AronTech1/chord_hardware/Chord Board Controller.step

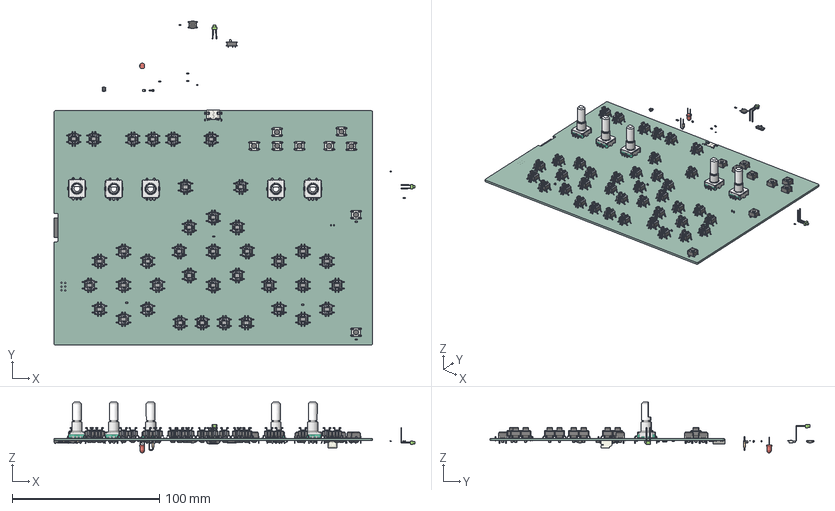
[picture p1: CAD file, 2025-10-28]
Chord Board Controller.step
244.8 x 219.7 x 34.5 mm
root x 39
(Unsaved) x 5
SW_PUSH_6mm x 9
LED_0603_1608Metric x 6
LED_D1.8mm_W1.8mm_H2.4mm_Horizontal_O6.35mm_Z8.2mm x 2
C_0402_1005Metric x 21
D_SOD_123 x 53
R_0402_1005Metric x 20
R_Axial_DIN0204_L36mm_D16mm_P254mm_Vertical
Fuse_0805_2012Metric
C_0805_2012Metric x 2
SW_SPST_TL3342 x 2
SOT_23_6
CON_TYPE-C-31-M-14 v3
R_0603_1608Metric x 11
JST_S2B_PH_K
C_0603_1608Metric x 3
holyiot_18010_nRF52840 v3
SOT_23 x 2
RGT16B
ASSEMBLY x 2
MSK12C02 v4
LED_D3.0mm
Chord Board Controller_PCB
