AronTech1/chord_hardware/step file/IS31FL3733-QFLS4-TR.stp

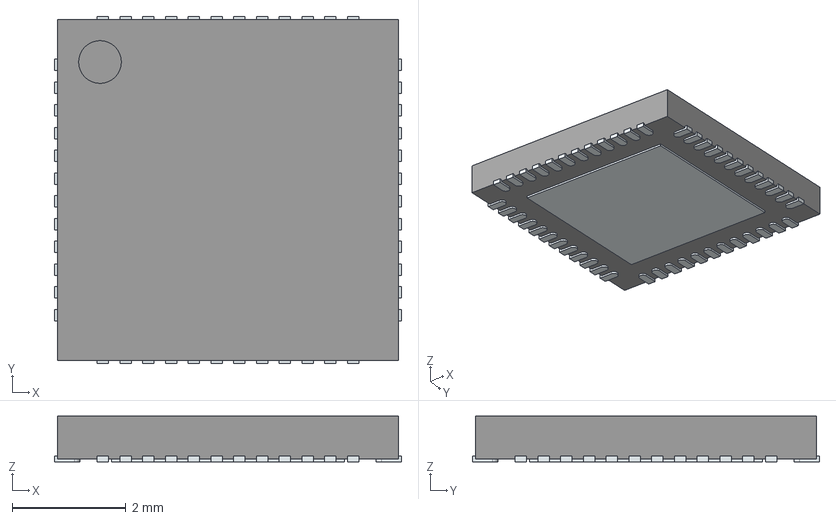
[picture p2: CAD file, 2025-10-28]
step file/IS31FL3733-QFLS4-TR.stp
6.10 x 6.10 x 0.8 mm
ThermalPin
PinsArrayLR
PinsArrayTB
