AronTech1/chord_hardware/step file/BQ24075.STEP

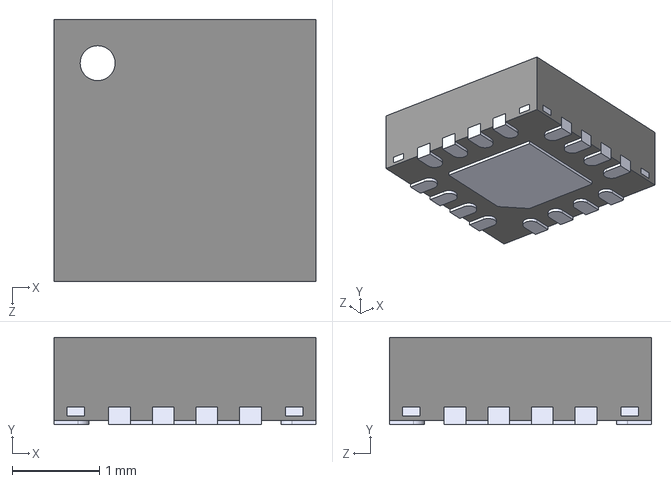
[picture p3: CAD file, 2025-10-28]
step file/BQ24075.STEP
3.00 x 1.00 x 3.00 mm
