AronTech1/chord_hardware/Schematic_19-10-25.pdf

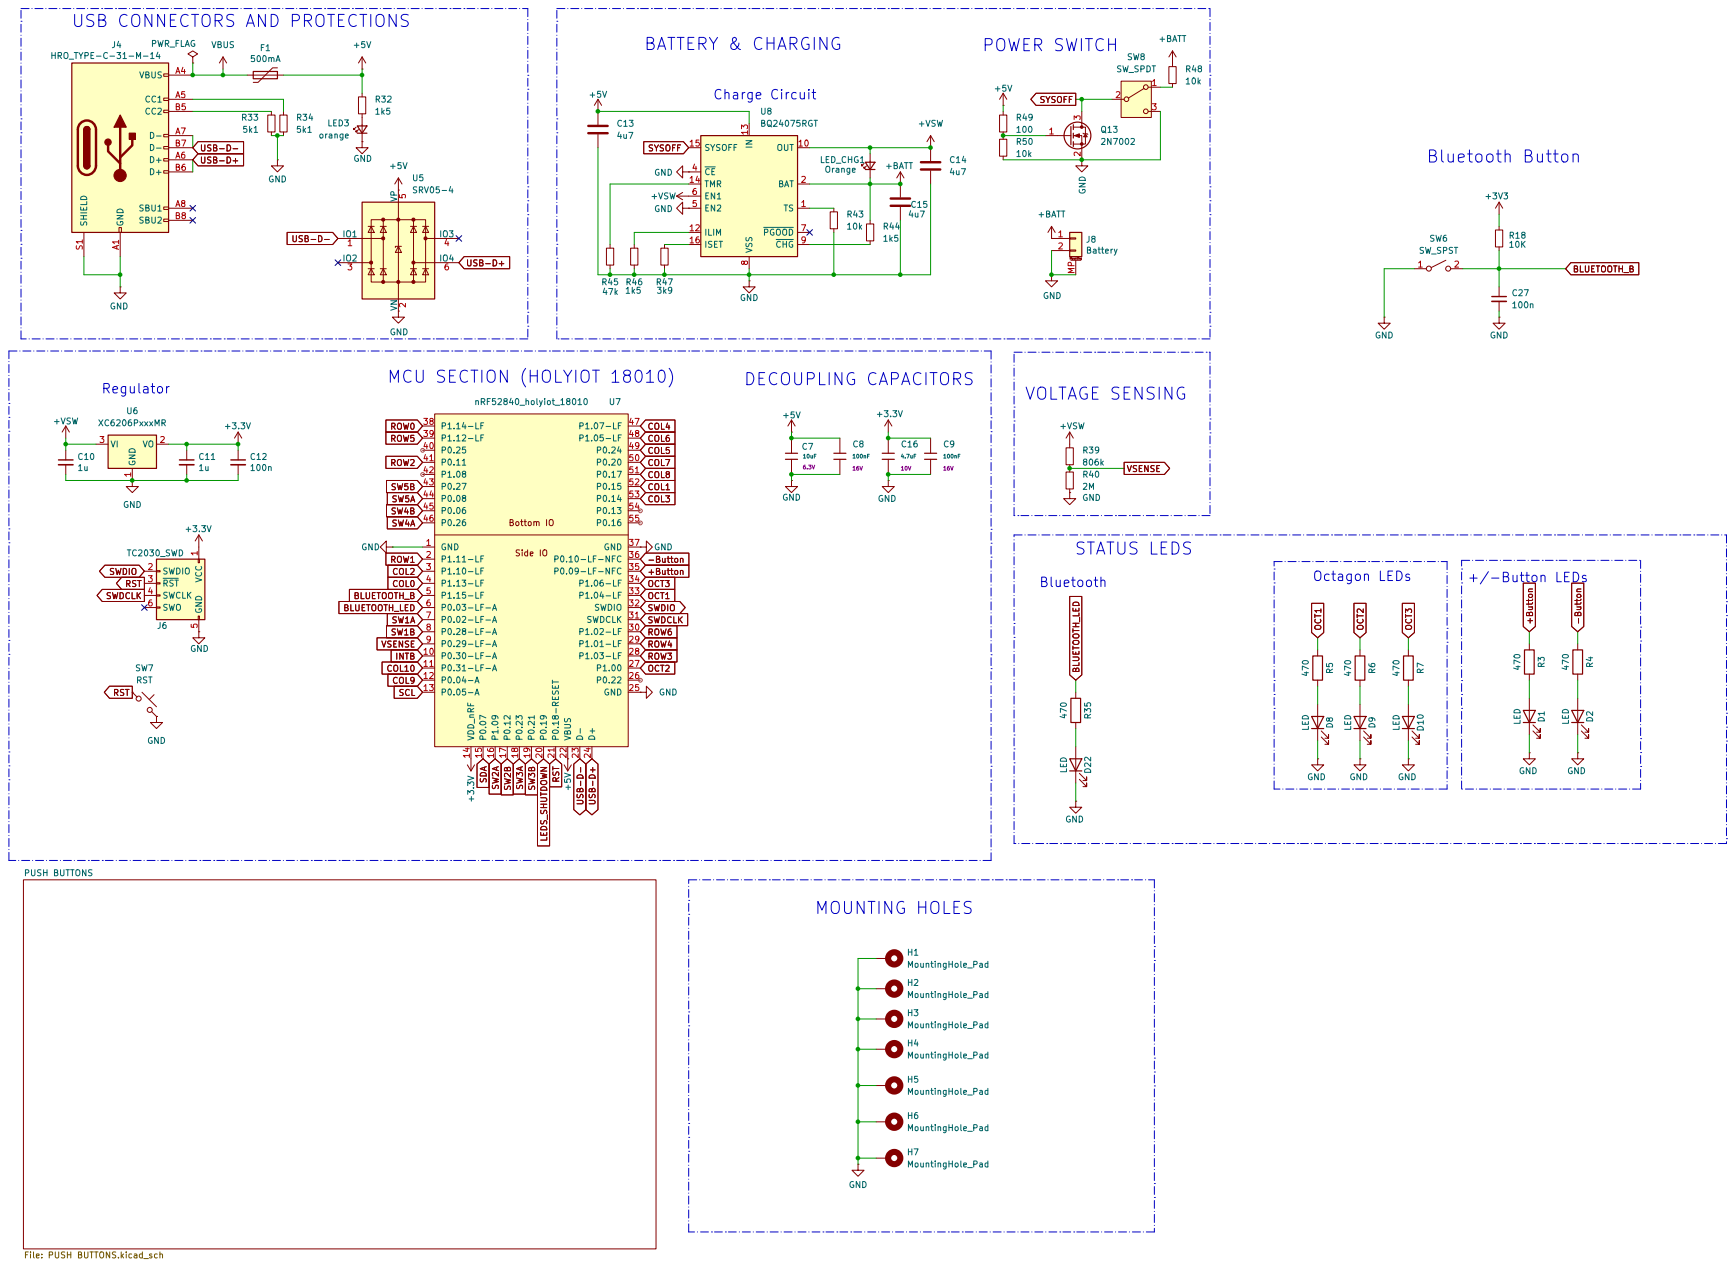
[picture p4: page 1]

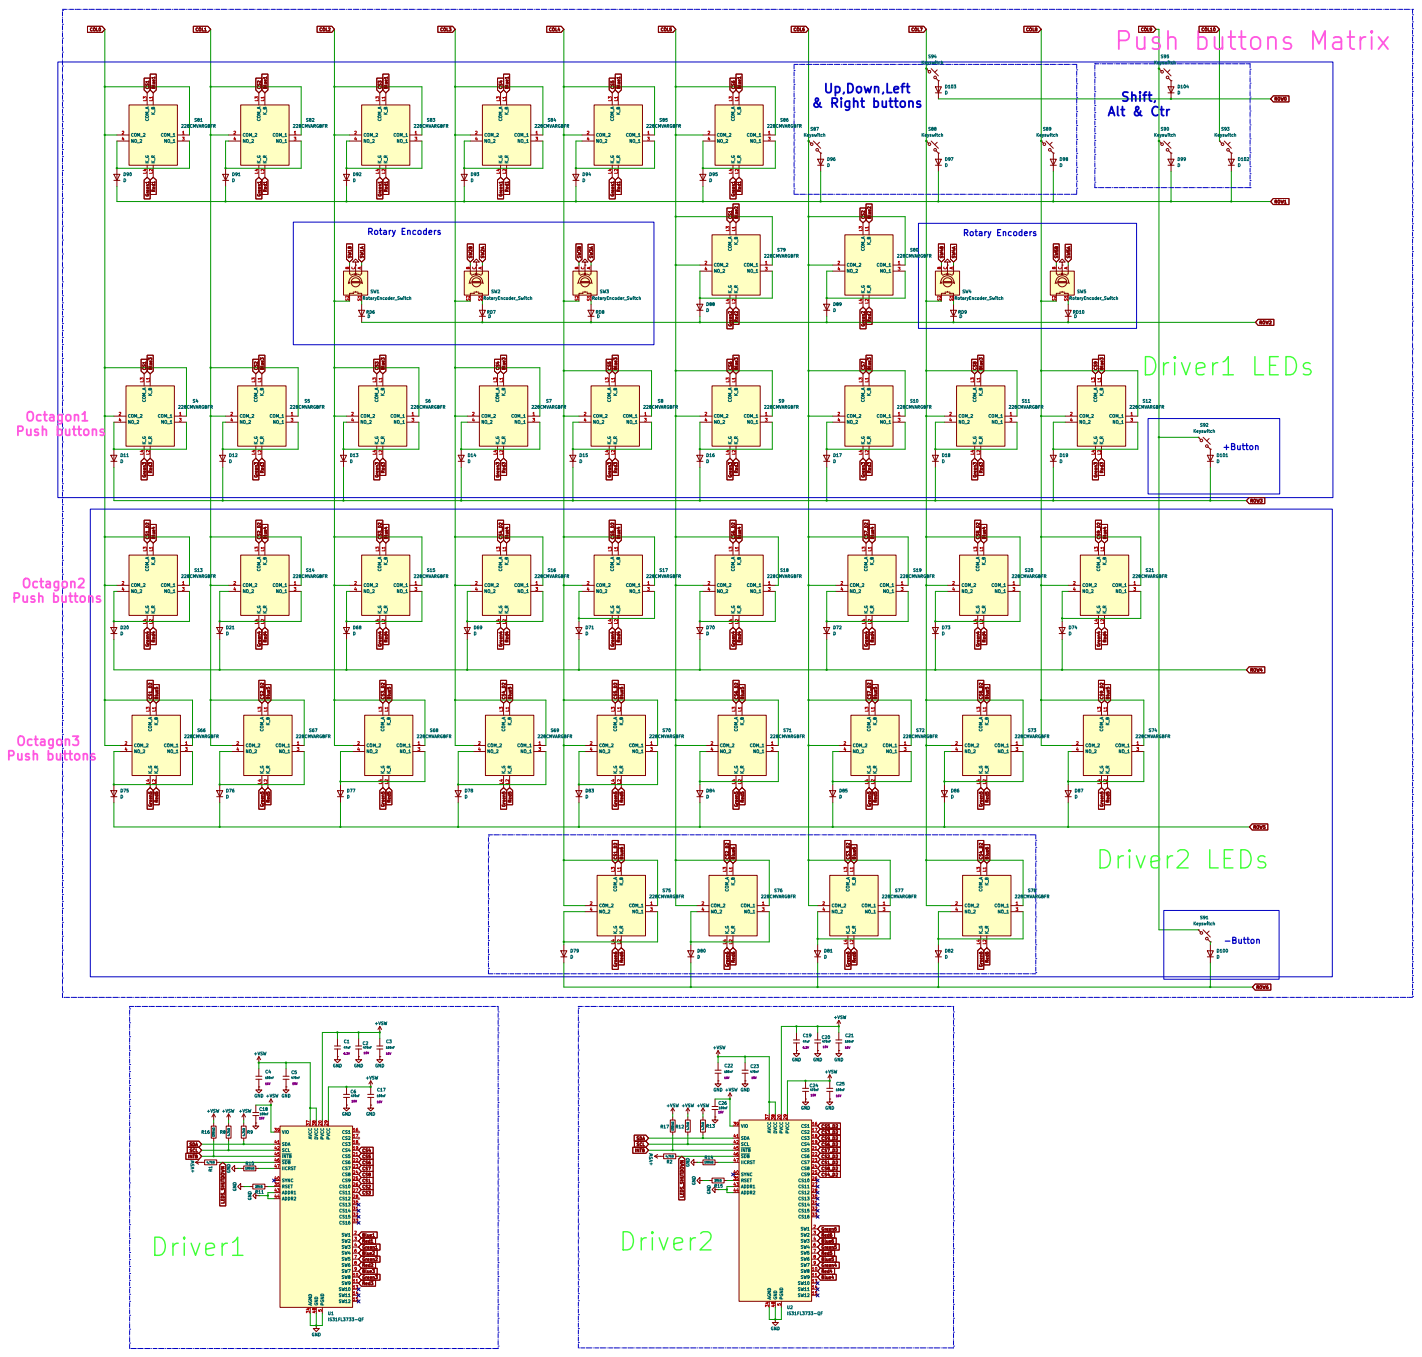
[picture p5: page 2]
