AronTech1/chord_hardware/Chord Board Controller.kicad_pcb

## KiCad design Chord Board Controller.kicad_pcb (2025-10-28)

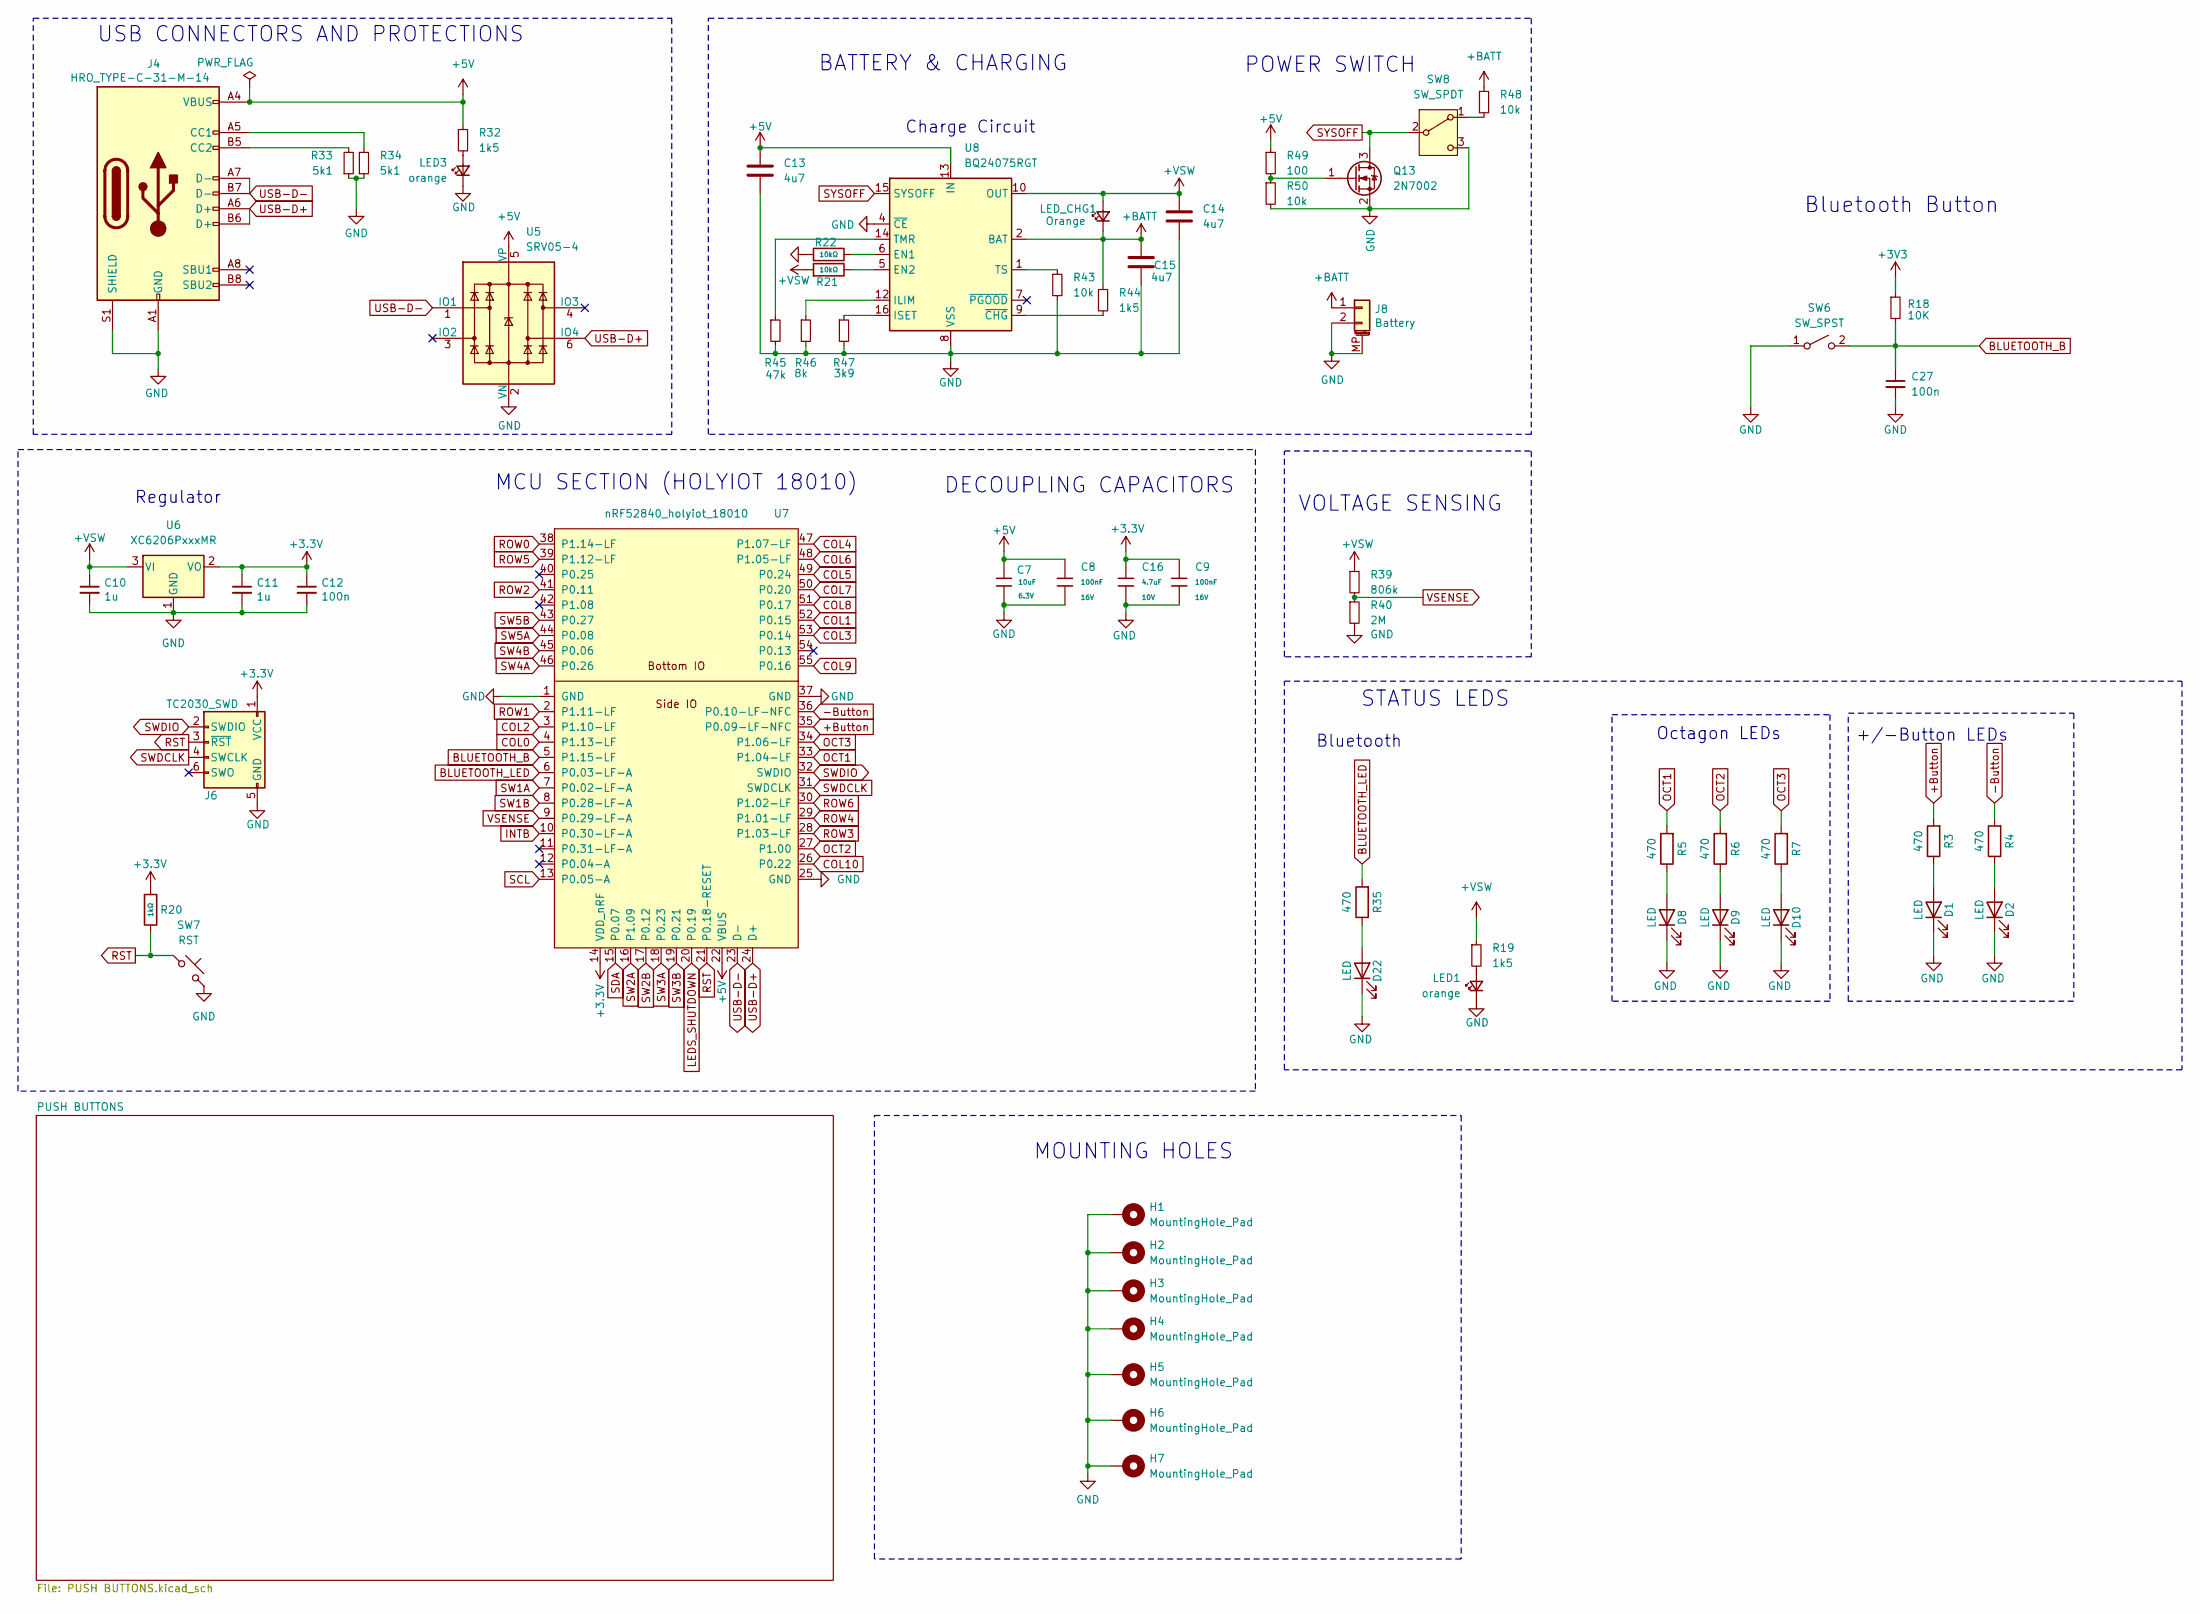
[picture p6: schematic Chord Board Controller.kicad_sch]

Parts:
C7: 10uF; C_0402; Voltage Rated 6.3V; Tolerance ±20%; Part CL05A106MQ5NUNC; LCSC C15525
C8, C9: 100nF; C_0402; Voltage Rated 16V; Tolerance ±10%; Part CL05B104KO5NNNC; LCSC C1525
C10, C11: 1u; C_0402_1005Metric; MFR.Part # CL05A105KP5NNNC; JLCPCB part# C14445
C12: 100n; C_0402_1005Metric; MFR.Part # CL05B104KO5NNNC; JLCPCB part# C1525
C13, C14, C15: 4u7; C_0603_1608Metric
C16: 4.7uF; C_0402; Voltage Rated 10V; Tolerance ±20%; Part CL05A475MP5NRNC; LCSC C23733
C27: 100n; C_0402_1005Metric_Pad0.74x0.62mm_HandSolder; Manufacturer Part # GCM155R71H104KE02J; LCSC C2649549
D1, D2, D8, D9, D10: LED; LED_0603_1608Metric
D22: LED; LED_D1.8mm_W1.8mm_H2.4mm_Horizontal_O6.35mm_Z8.2mm
H1, H2, H3, H4, H5, H6, H7: MountingHole_Pad; MountingHole_2.2mm_M2; MFR.Part # DNP; JLCPCB part# DNP
J4: HRO_TYPE-C-31-M-14; USB_C_Receptacle_HRO_TYPE-C-31-M-14; MFR.Part # TYPE-C-31-M-12; JLCPCB part# C165948
J6: TC2030_SWD; CON_TC2030_outlined; MFR.Part # DNP; JLCPCB part# DNP
J8: Battery; JST_PH_S2B-PH-K_1x02_P2.00mm_Horizontal; LCSC C505023
LED1, LED3: orange; LED_D1.8mm_W1.8mm_H2.4mm_Horizontal_O6.35mm_Z8.2mm
LED_CHG1: Orange; LED_D1.8mm_W1.8mm_H2.4mm_Horizontal_O6.35mm_Z8.2mm
Q13: 2N7002; SOT-23
R3, R4, R5, R6, R7: 470; R_0402_1005Metric
R18: 10K; R_0402_1005Metric_Pad0.72x0.64mm_HandSolder; Manufacturer Part # CRCW040210K0FKED; LCSC C71617
R19, R32: 1k5; R_0402_1005Metric; MFR.Part # 0402WGF1501TCE; JLCPCB part# C25867
R20: 1kΩ; R_0402; Overload Voltage (Max) 50V; Tolerance ±1%; Part 0402WGF1001TCE; LCSC C11702
R21, R22: 10kΩ; R_0402; Overload Voltage (Max) 50V; Tolerance ±1%; Part 0402WGF1002TCE; LCSC C25744
R33, R34: 5k1; R_0402_1005Metric; MFR.Part # 0402WGF5101TCE; JLCPCB part# C25905
R35: 470; R_0603
R39: 806k; R_0402_1005Metric; MFR.Part # 0402WGF8063TCE; JLCPCB part# C29263
R40: 2M; R_0402_1005Metric; MFR.Part # 0402WGF2004TCE; JLCPCB part# C11512
R43, R48, R50: 10k; R_0603_1608Metric_Pad0.98x0.95mm_HandSolder
R44: 1k5; R_0603_1608Metric_Pad0.98x0.95mm_HandSolder
R45: 47k; R_0603_1608Metric_Pad0.98x0.95mm_HandSolder
R46: 8k; R_0603_1608Metric_Pad0.98x0.95mm_HandSolder
R47: 3k9; R_0603_1608Metric_Pad0.98x0.95mm_HandSolder
R49: 100; R_0603_1608Metric_Pad0.98x0.95mm_HandSolder
SW6: SW_SPST; SW_Tactile_SPST_Angled_PTS645Vx31-2LFS; Manufacturer Part # DTSA-61K-V; LCSC C483771
SW7: RST; SW_SPST_SKQG_WithStem; MFR.Part # FRC0402F1101TS; JLCPCB part# C2909306
SW8: SW_SPDT; SW_MSK12C02-HB
U5: SRV05-4; SOT-23-6; MFR.Part # SRV05-4-P-T7; JLCPCB part# C179173
U6: XC6206PxxxMR; SOT-23; MFR.Part # XC6202P332MR-G; JLCPCB part# C47374
U7: nRF52840_holyiot_18010
U8: BQ24075RGT; VQFN-16-1EP_3x3mm_P0.5mm_EP1.6x1.6mm

Connections:
+3.3V: C9.1, C11.1, C12.1, C16.1, J6.1 (VCC), R20.1, U6.2 (VO), U7.14 (VDD_nRF)
+3V3: R18.1
+BATT: C15.1, J8.1, LED_CHG1.1 (K), R44.1, R48.1, U8.2 (BAT), U8.3 (BAT)
+Button: R3.2, U7.35 (P0.09-LF-NFC)
-Button: R4.2, U7.36 (P0.10-LF-NFC)
BLUETOOTH_B: C27.1, R18.2, SW6.2 (B), U7.5 (P1.15-LF)
BLUETOOTH_LED: R35.2, U7.6 (P0.03-LF-A)
COL0: U7.4 (P1.13-LF); also elsewhere on the board
COL1: U7.52 (P0.15); also elsewhere on the board
COL2: U7.3 (P1.10-LF); also elsewhere on the board
COL3: U7.53 (P0.14); also elsewhere on the board
COL4: U7.47 (P1.07-LF); also elsewhere on the board
COL5: U7.49 (P0.24); also elsewhere on the board
COL6: U7.48 (P1.05-LF); also elsewhere on the board
COL7: U7.50 (P0.20); also elsewhere on the board
COL8: U7.51 (P0.17); also elsewhere on the board
COL9: U7.55 (P0.16); also elsewhere on the board
COL10: U7.26 (P0.22); also elsewhere on the board
GND: C7.2, C8.2, C9.2, C10.2, C11.2, C12.2, C13.2, C14.2, C15.2, C16.2, C27.2, D1.1 (K), D2.1 (K), D8.1 (K), D9.1 (K), D10.1 (K), D22.1 (K), H1.1, H2.1, H3.1, H4.1, H5.1, H6.1, H7.1, J4.A1 (GND), J4.A12 (GND), J4.B1 (GND), J4.B12 (GND), J4.S1 (SHIELD), J6.5 (GND), J8.2, J8.MP (MountPin), LED1.1 (K), LED3.1 (K), Q13.2 (S), R21.2, R22.1, R33.1, R34.1, R40.2, R43.2, R45.2, R46.2, R47.2, R50.2, SW6.1 (A), SW7.2, SW8.3 (C), U5.2 (VN), U6.1 (GND), U7.1 (GND), U7.25 (GND), U7.37 (GND), U8.4 (~CE), U8.5 (EN2), U8.8 (VSS), U8.17 (VSS); also elsewhere on the board
INTB: U7.10 (P0.30-LF-A); also elsewhere on the board
LEDS_SHUTDOWN: U7.20 (P0.19); also elsewhere on the board
unnamed: D1.2 (A), R3.1
unnamed: D2.2 (A), R4.1
unnamed: D8.2 (A), R5.1
unnamed: D9.2 (A), R6.1
unnamed: D10.2 (A), R7.1
unnamed: D22.2 (A), R35.1
unnamed: J4.A5 (CC1), R34.2
unnamed: J4.B5 (CC2), R33.2
unnamed: LED1.2 (A), R19.2
unnamed: LED3.2 (A), R32.2
unnamed: Q13.1 (G), R49.2, R50.1
unnamed: R48.2, SW8.1 (A)
unnamed: R46.1, U8.12 (ILIM)
unnamed: R47.1, U8.16 (ISET)
unnamed: R45.1, U8.14 (TMR)
unnamed: R43.1, U8.1 (TS)
unnamed: R44.2, U8.9 (~CHG)
OCT1: R5.2, U7.33 (P1.04-LF)
OCT2: R6.2, U7.27 (P1.00)
OCT3: R7.2, U7.34 (P1.06-LF)
ROW0: U7.38 (P1.14-LF); also elsewhere on the board
ROW1: U7.2 (P1.11-LF); also elsewhere on the board
ROW2: U7.41 (P0.11); also elsewhere on the board
ROW3: U7.28 (P1.03-LF); also elsewhere on the board
ROW4: U7.29 (P1.01-LF); also elsewhere on the board
ROW5: U7.39 (P1.12-LF); also elsewhere on the board
ROW6: U7.30 (P1.02-LF); also elsewhere on the board
RST: J6.3 (~RST), R20.2, SW7.1, U7.21 (P0.18-RESET)
SCL: U7.13 (P0.05-A); also elsewhere on the board
SDA: U7.15 (P0.07); also elsewhere on the board
SW1A: U7.7 (P0.02-LF-A); also elsewhere on the board
SW1B: U7.8 (P0.28-LF-A); also elsewhere on the board
SW2A: U7.16 (P1.09); also elsewhere on the board
SW2B: U7.17 (P0.12); also elsewhere on the board
SW3A: U7.18 (P0.23); also elsewhere on the board
SW3B: U7.19 (P0.21); also elsewhere on the board
SW4A: U7.46 (P0.26); also elsewhere on the board
SW4B: U7.45 (P0.06); also elsewhere on the board
SW5A: U7.44 (P0.08); also elsewhere on the board
SW5B: U7.43 (P0.27); also elsewhere on the board
SWDCLK: J6.4 (SWCLK), U7.31 (SWDCLK)
SWDIO: J6.2 (SWDIO), U7.32 (SWDIO)
SYSOFF: Q13.3 (D), SW8.2 (B), U8.15 (SYSOFF)
USB-D+: J4.A6 (D+), J4.B6 (D+), U5.6 (IO4), U7.24 (D+)
USB-D-: J4.A7 (D-), J4.B7 (D-), U5.1 (IO1), U7.23 (D-)
VSENSE: R39.2, R40.1, U7.9 (P0.29-LF-A)

Notes on the sheet:
USB CONNECTORS AND PROTECTIONS
+/-Button LEDs
POWER SWITCH
MOUNTING HOLES
Regulator
Octagon LEDs
MCU SECTION (HOLYIOT 18010)
Bluetooth Button
VOLTAGE SENSING
DECOUPLING CAPACITORS
STATUS LEDS
Bluetooth
Charge Circuit
BATTERY & CHARGING
