AronTech1/chord_hardware/Chord Board Controller.kicad_pcb

## KiCad design Chord Board Controller.kicad_pcb (continued)

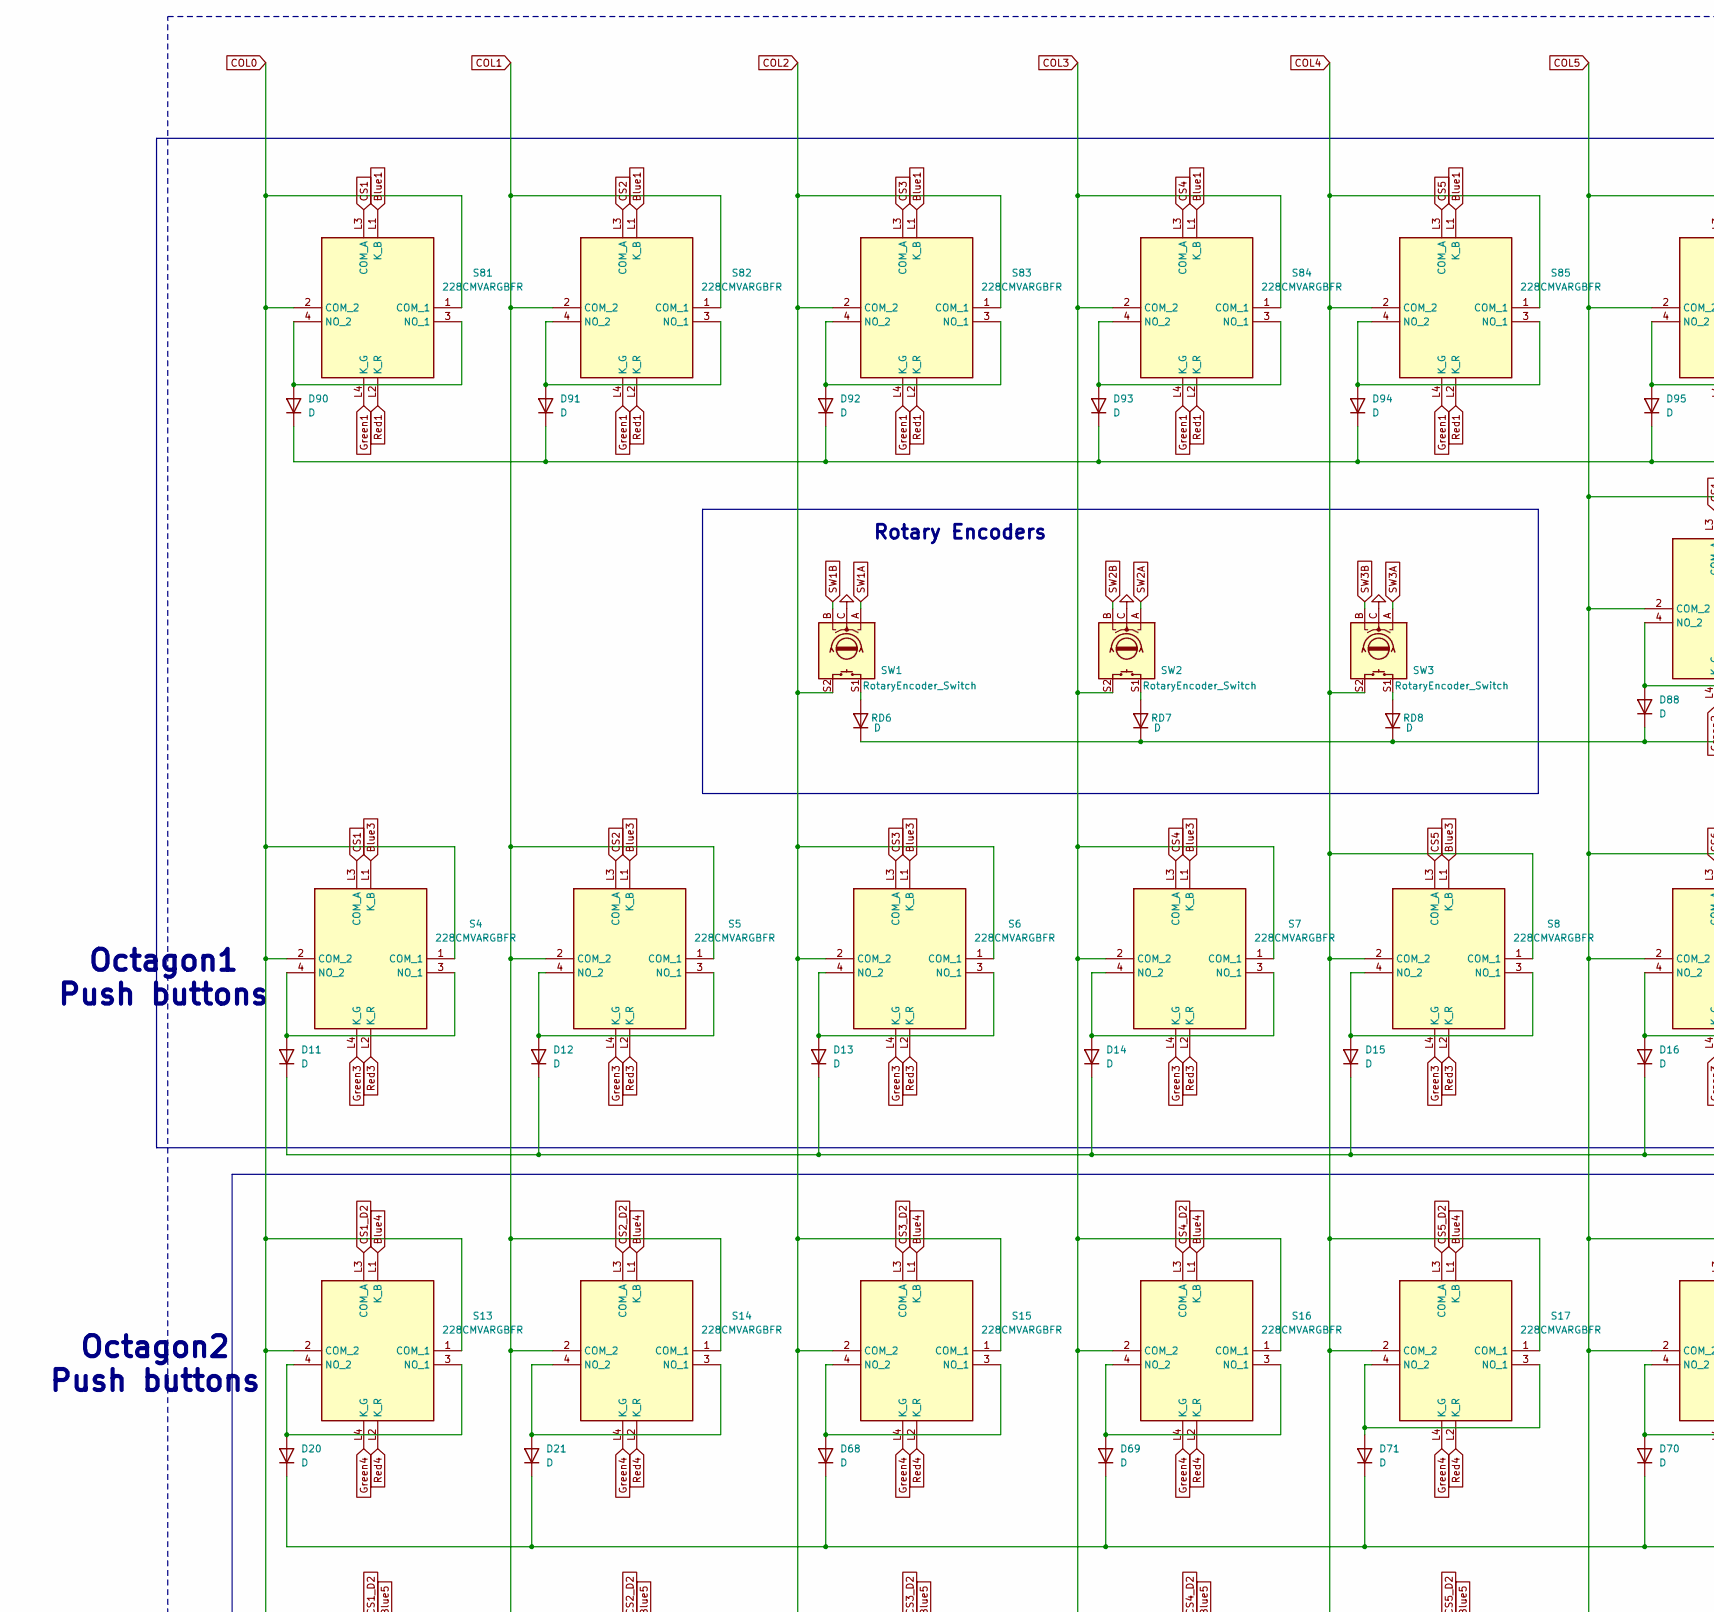
[picture p7: schematic PUSH BUTTONS.kicad_sch, part in row 1, column 1]

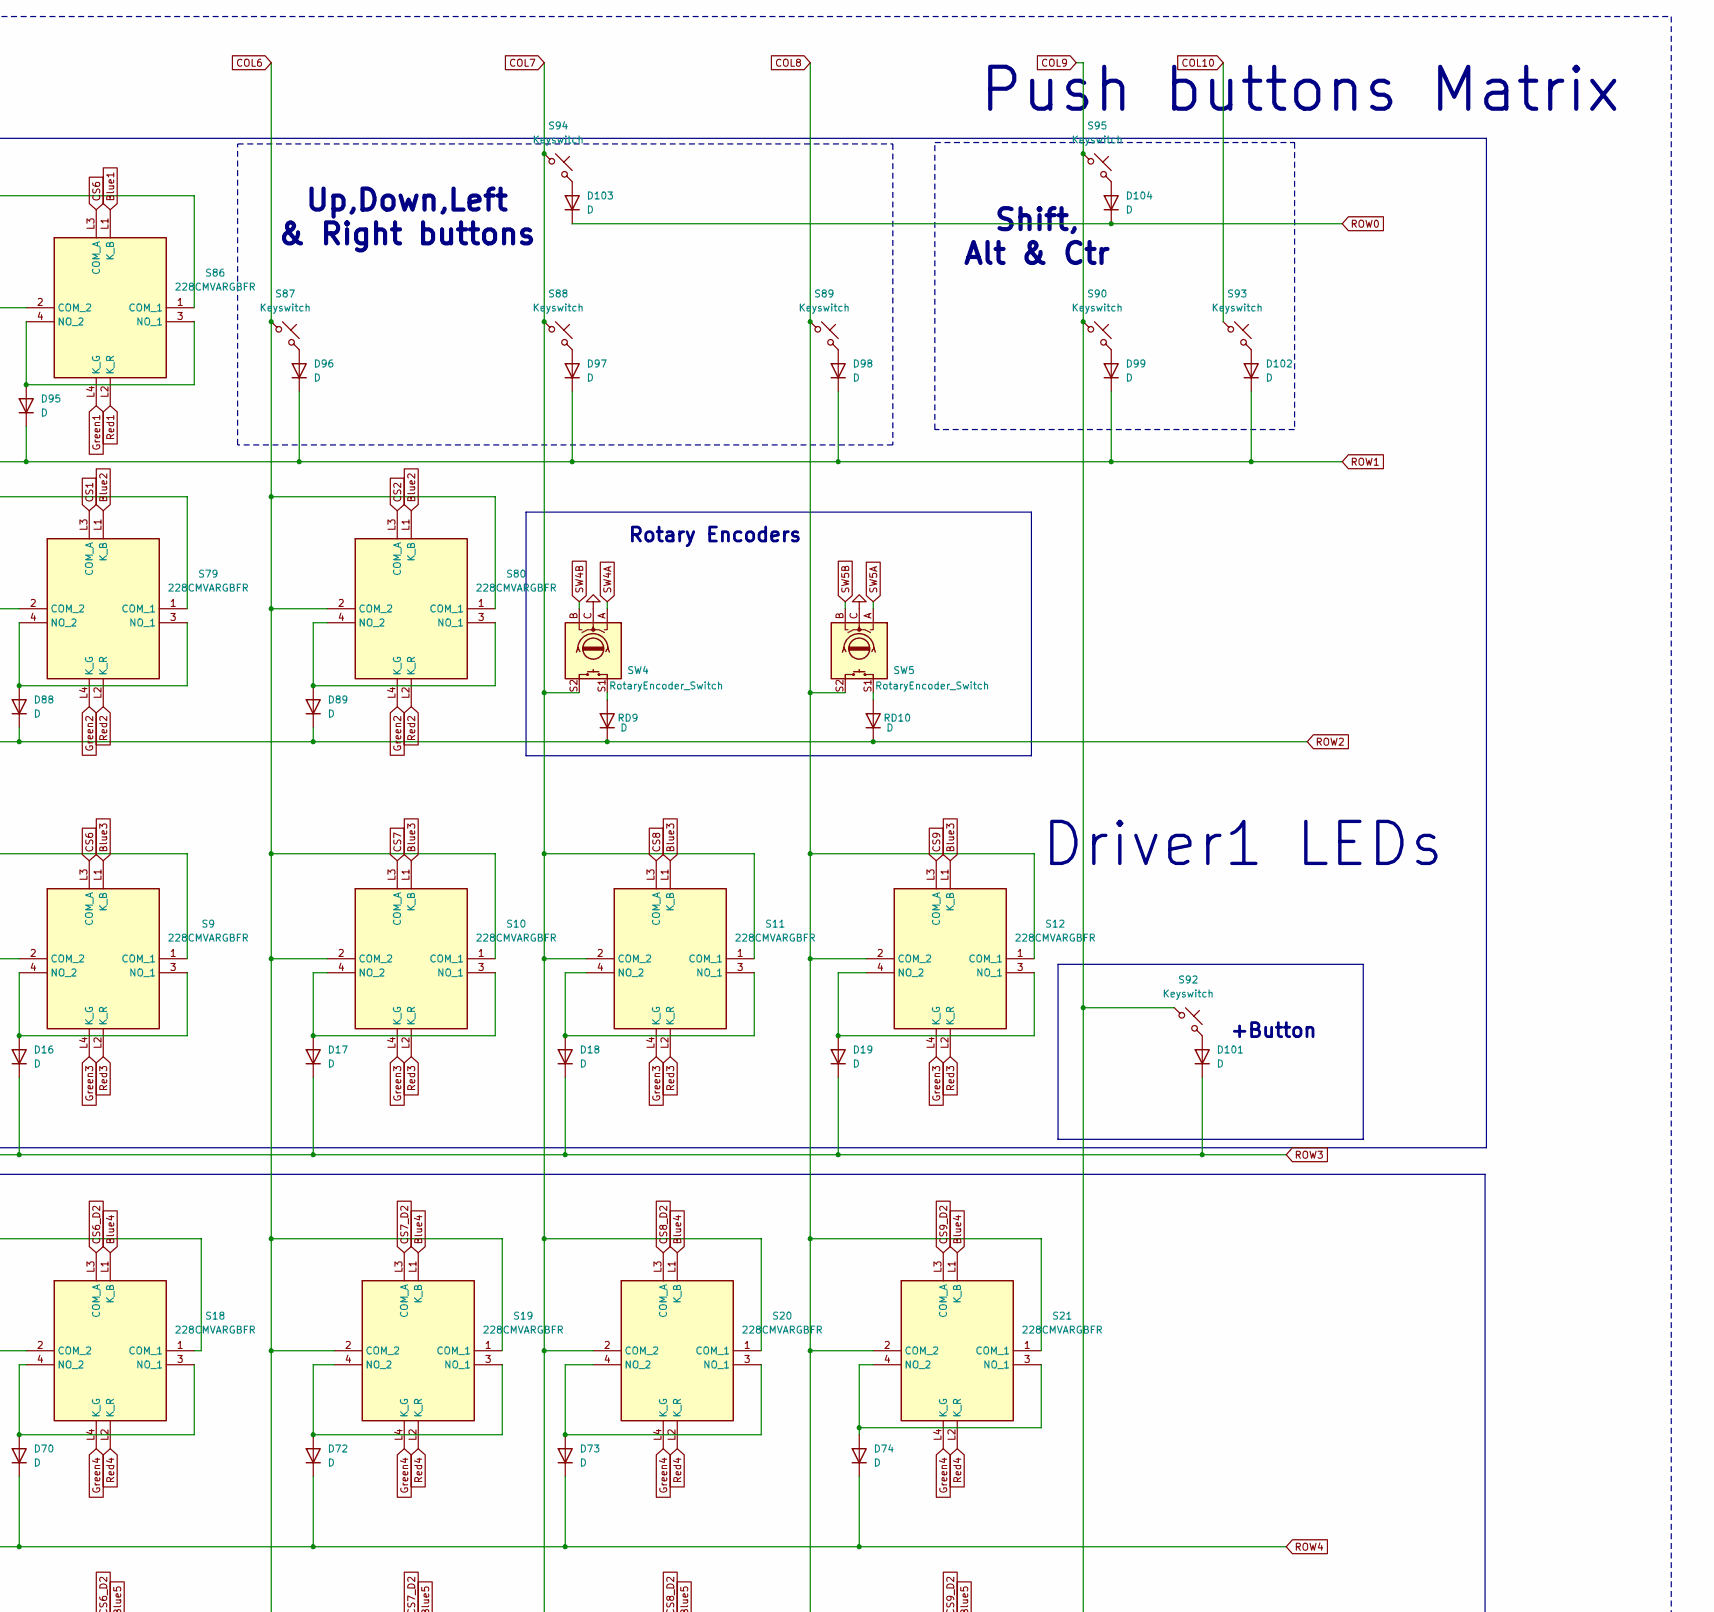
[picture p8: schematic PUSH BUTTONS.kicad_sch, part in row 1, column 2]

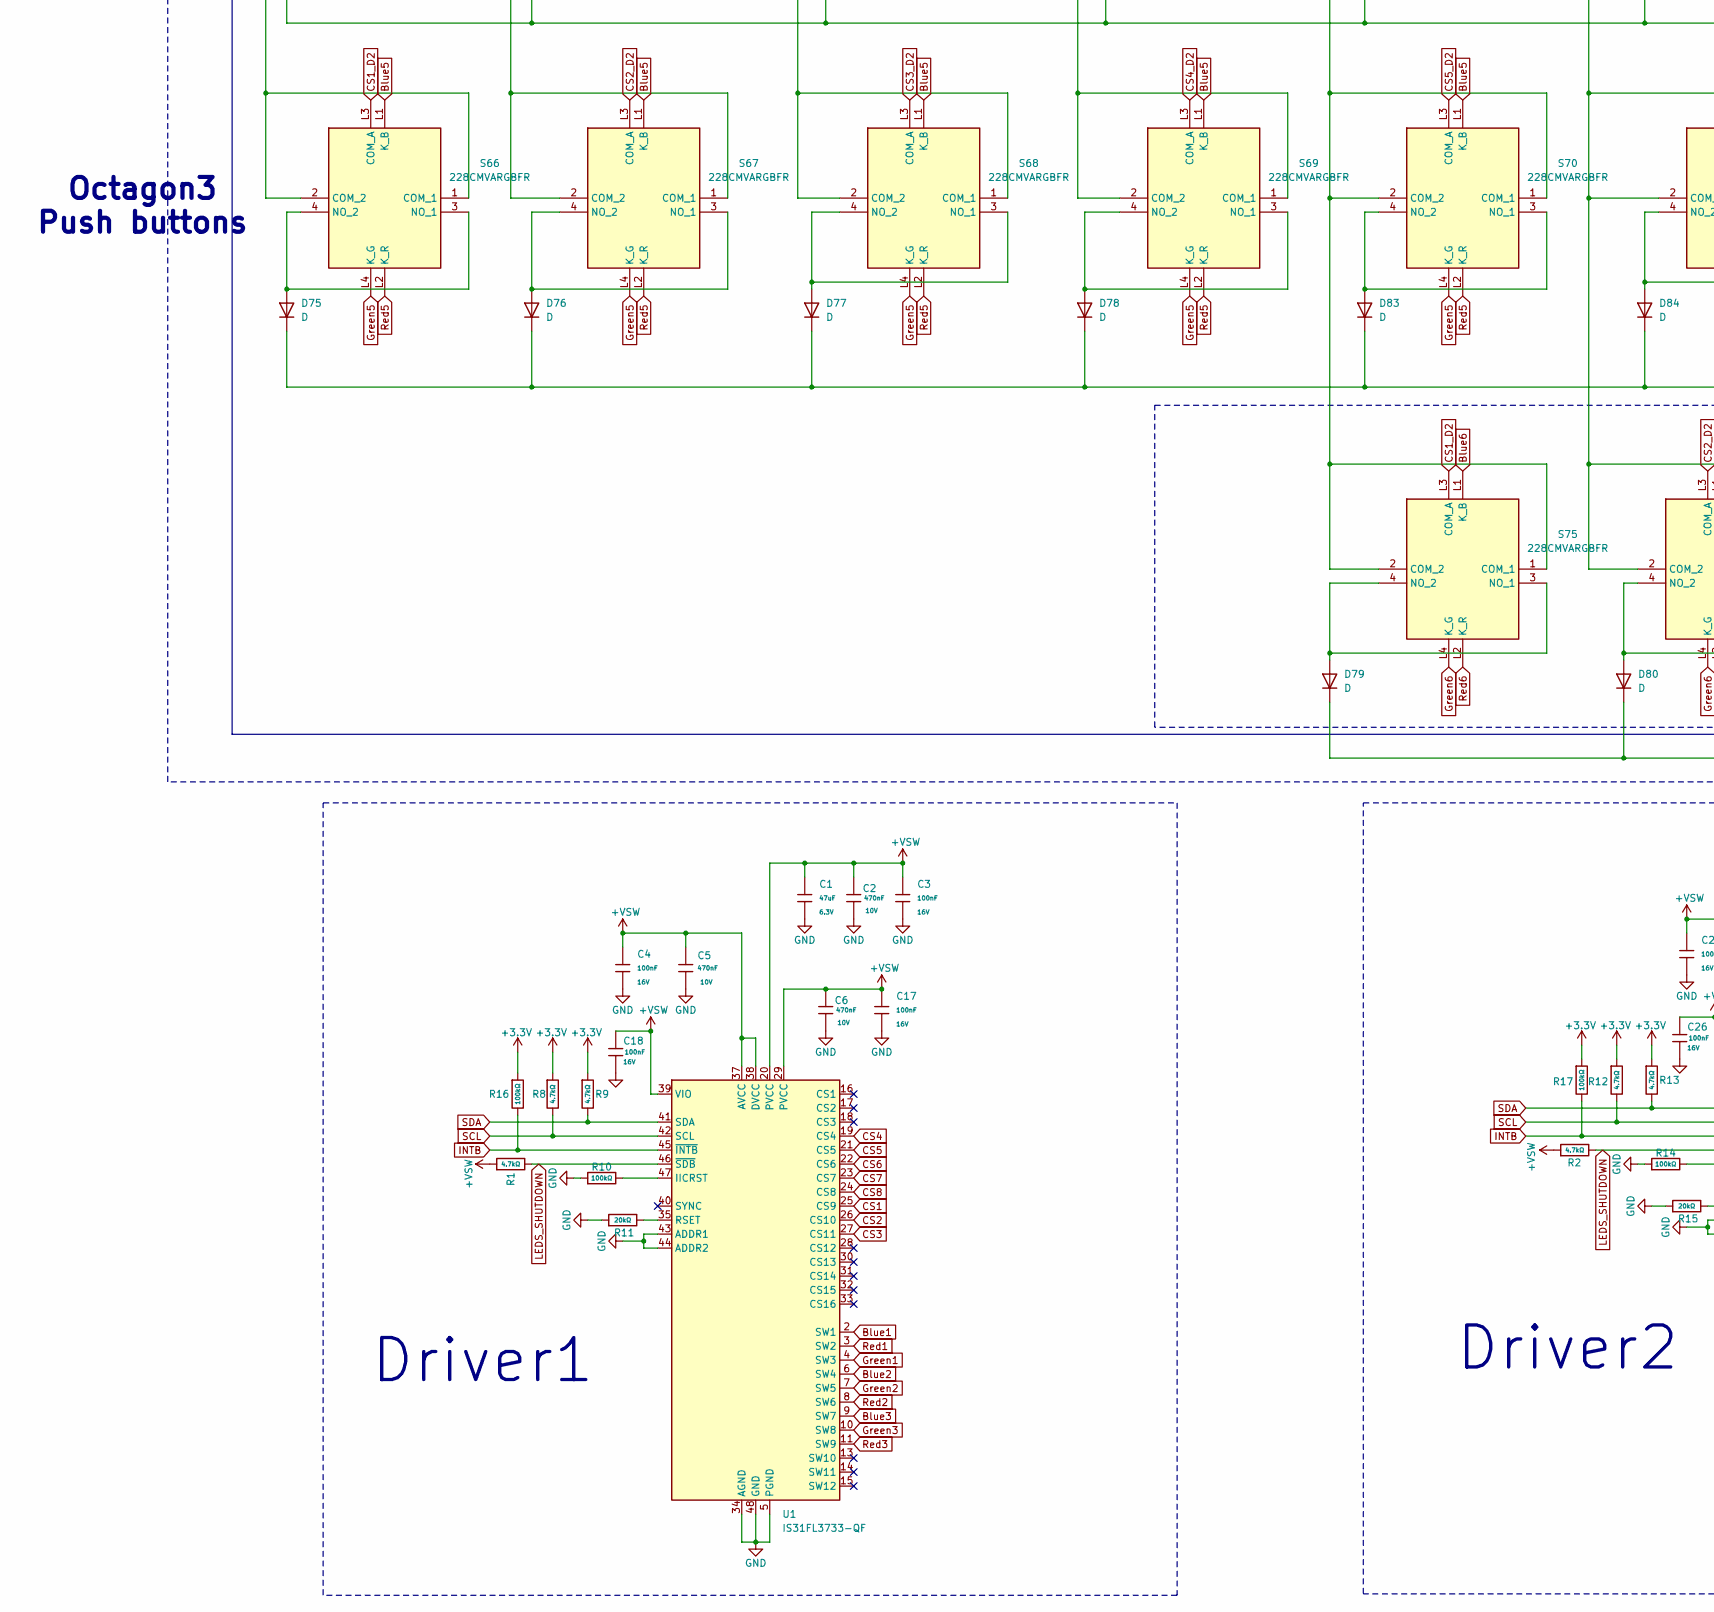
[picture p9: schematic PUSH BUTTONS.kicad_sch, part in row 2, column 1]

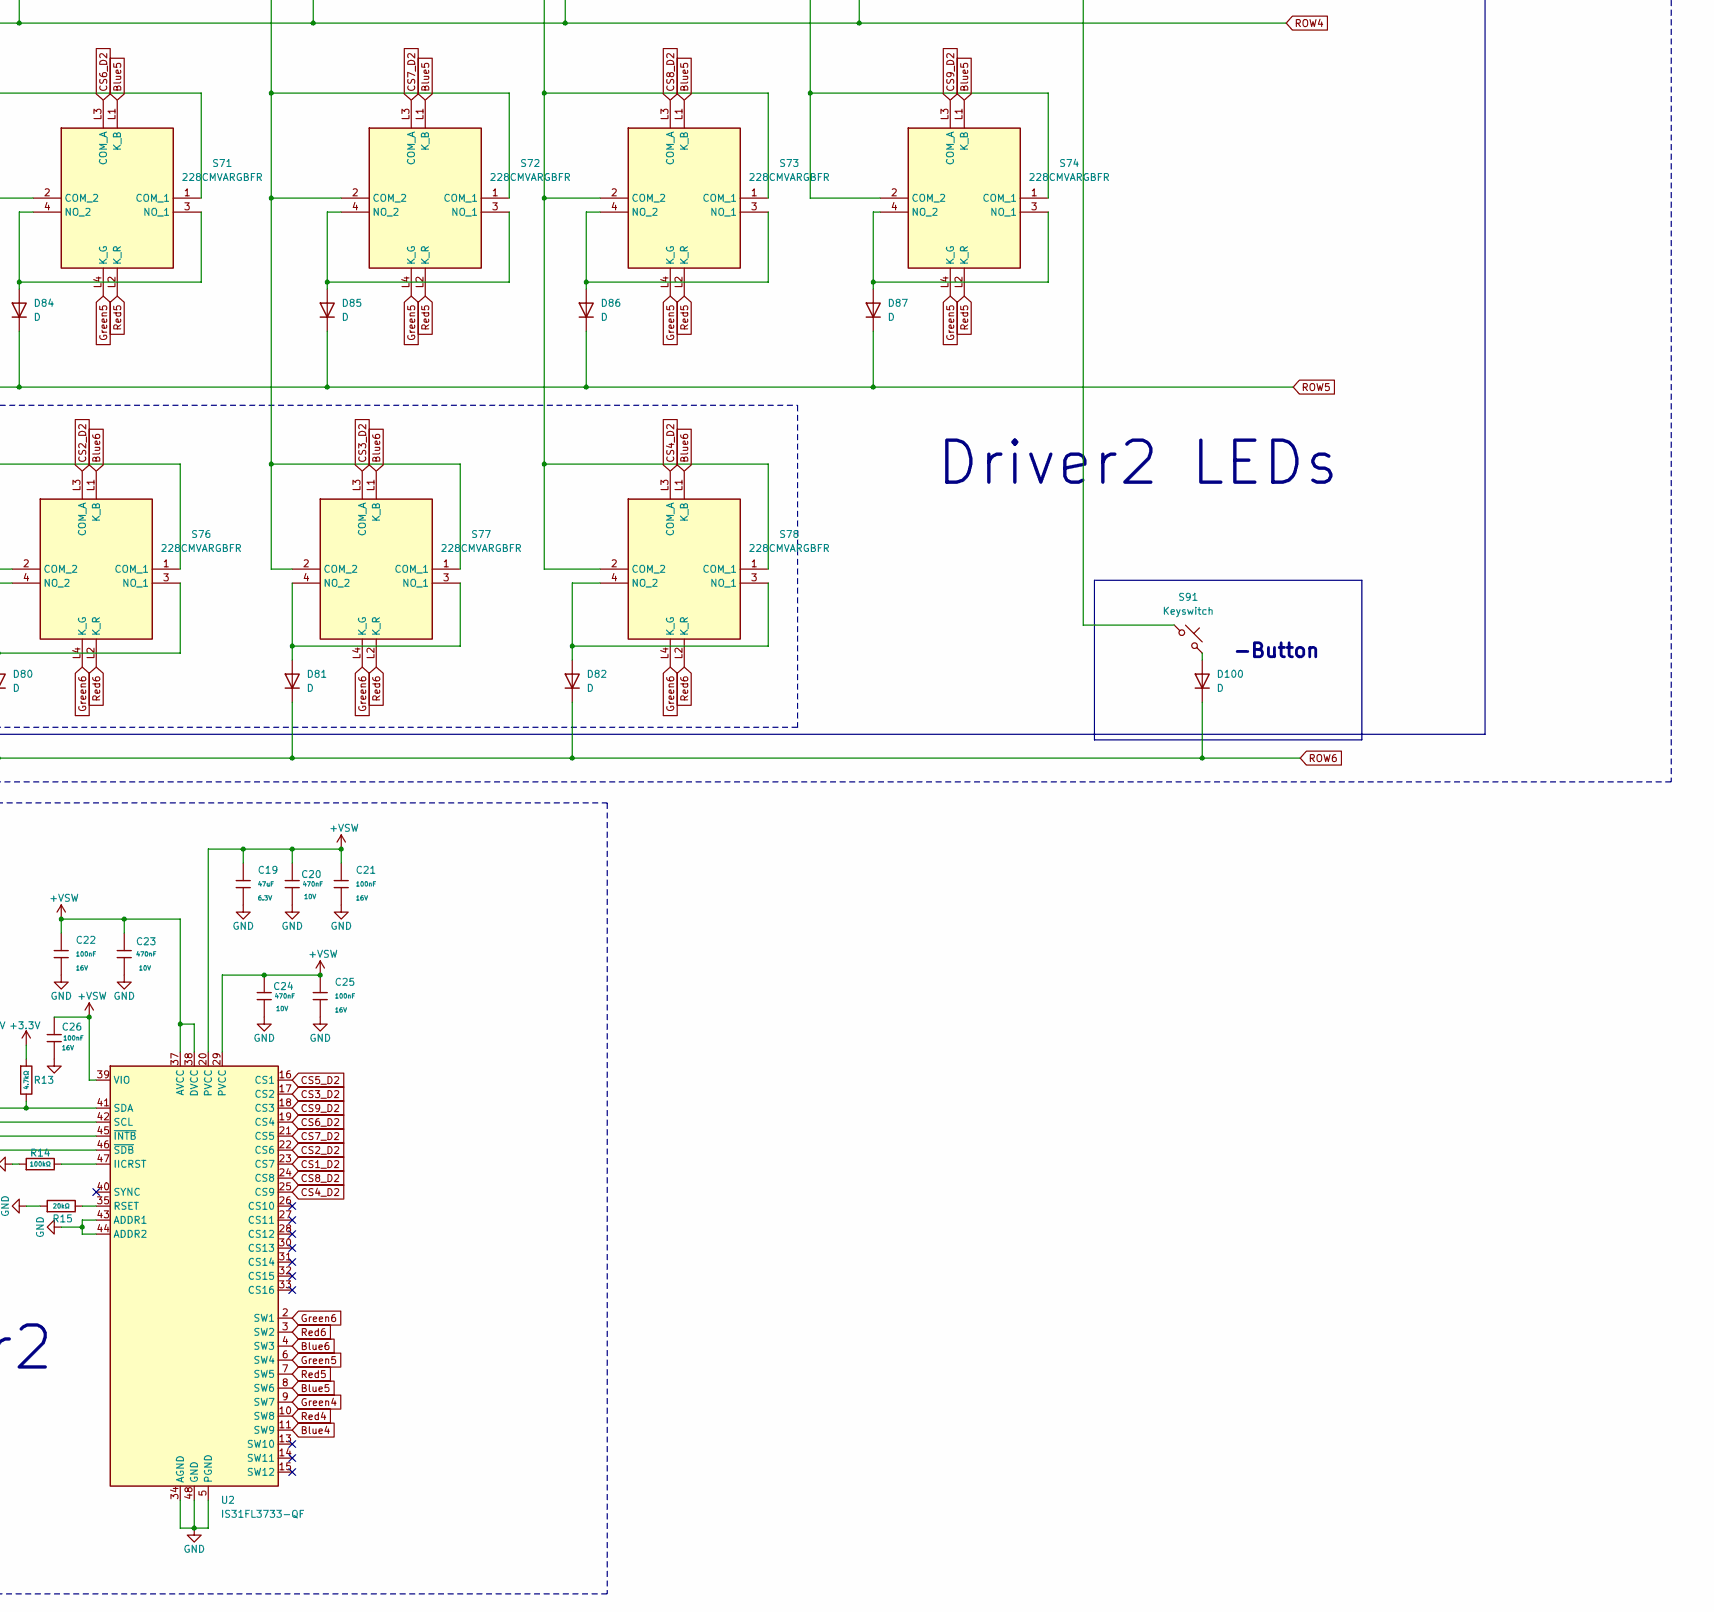
[picture p10: schematic PUSH BUTTONS.kicad_sch, part in row 2, column 2]

Parts:
C1, C19: 47uF; C_0805; Voltage Rated 6.3V; Tolerance ±20%; Part CL21A476MQYNNNE; LCSC C16780
C2, C5, C6, C20, C23, C24: 470nF; C_0402; Voltage Rated 10V; Tolerance ±10%; Part CL05A474KP5NNNC; LCSC C47339
C3, C4, C17, C18, C21, C22, C25, C26: 100nF; C_0402; Voltage Rated 16V; Tolerance ±10%; Part CL05B104KO5NNNC; LCSC C1525
D11, D12, D13, D14, D15, D16, D17, D18, D19, D20, D21, D68, D69, D70, D71, D72, D73, D74, D75, D76, D77, D78, D79, D80, D81, D82, D83, D84, D85, D86, D87, D88, D89, D90, D91, D92, D93, D94, D95, D96, D97, D98, D99, D100, D101, D102, D103, D104: D; D_SOD-123; MFR.Part # SOD1F7; JLCPCB part# C33221
R1, R2, R8, R9, R12, R13: 4.7kΩ; R_0402; Overload Voltage (Max) 50V; Tolerance ±1%; Part 0402WGF4701TCE; LCSC C25900
R10, R14: 100kΩ; R_0402; Overload Voltage (Max) 50V; Tolerance ±1%; Part 0402WGF1003TCE; LCSC C25741
R11, R15: 20kΩ; R_0402; Overload Voltage (Max) 50V; Tolerance ±1%; Part 0402WGF2002TCE; LCSC C25765
R16, R17: 100kΩ; R_0603; Overload Voltage (Max) 75V; Tolerance ±1%; Part 0603WAF1003T5E; LCSC C25803
RD6, RD7, RD8, RD9, RD10: D; D_SOD-123
S4, S5, S6, S7, S8, S9, S10, S11, S12, S13, S14, S15, S16, S17, S18, S19, S20, S21, S66, S67, S68, S69, S70, S71, S72, S73, S74, S75, S76, S77, S78, S79, S80, S81, S82, S83, S84, S85, S86: 228CMVARGBFR; Mouser Part Number 774-228CMVARGBFR
S87, S88, S89, S90, S91, S92, S93, S94, S95: Keyswitch; SW_PUSH_6mm; MFR.Part # ZX-QC66-6.5CJ; JLCPCB part# C7470130
SW1, SW2, SW3, SW4, SW5: RotaryEncoder_Switch; ROT_Alps_EC11E-Switch
U1, U2: IS31FL3733-QF; QFN-48-1EP_6x6mm_P0.4mm_EP4.2x4.2mm

Connections:
Blue1: S81.L1 (K_B), S82.L1 (K_B), S83.L1 (K_B), S84.L1 (K_B), S85.L1 (K_B), S86.L1 (K_B), U1.2 (SW1)
Blue2: S79.L1 (K_B), S80.L1 (K_B), U1.6 (SW4)
Blue3: S4.L1 (K_B), S5.L1 (K_B), S6.L1 (K_B), S7.L1 (K_B), S8.L1 (K_B), S9.L1 (K_B), S10.L1 (K_B), S11.L1 (K_B), S12.L1 (K_B), U1.9 (SW7)
Blue4: S13.L1 (K_B), S14.L1 (K_B), S15.L1 (K_B), S16.L1 (K_B), S17.L1 (K_B), S18.L1 (K_B), S19.L1 (K_B), S20.L1 (K_B), S21.L1 (K_B), U2.11 (SW9)
Blue5: S66.L1 (K_B), S67.L1 (K_B), S68.L1 (K_B), S69.L1 (K_B), S70.L1 (K_B), S71.L1 (K_B), S72.L1 (K_B), S73.L1 (K_B), S74.L1 (K_B), U2.8 (SW6)
Blue6: S75.L1 (K_B), S76.L1 (K_B), S77.L1 (K_B), S78.L1 (K_B), U2.4 (SW3)
COL0: S4.1 (COM_1), S4.2 (COM_2), S13.1 (COM_1), S13.2 (COM_2), S66.1 (COM_1), S66.2 (COM_2), S81.1 (COM_1), S81.2 (COM_2); also elsewhere on the board
COL1: S5.1 (COM_1), S5.2 (COM_2), S14.1 (COM_1), S14.2 (COM_2), S67.1 (COM_1), S67.2 (COM_2), S82.1 (COM_1), S82.2 (COM_2); also elsewhere on the board
COL2: S6.1 (COM_1), S6.2 (COM_2), S15.1 (COM_1), S15.2 (COM_2), S68.1 (COM_1), S68.2 (COM_2), S83.1 (COM_1), S83.2 (COM_2), SW1.S2; also elsewhere on the board
COL3: S7.1 (COM_1), S7.2 (COM_2), S16.1 (COM_1), S16.2 (COM_2), S69.1 (COM_1), S69.2 (COM_2), S84.1 (COM_1), S84.2 (COM_2), SW2.S2; also elsewhere on the board
COL4: S8.1 (COM_1), S8.2 (COM_2), S17.1 (COM_1), S17.2 (COM_2), S70.1 (COM_1), S70.2 (COM_2), S75.1 (COM_1), S75.2 (COM_2), S85.1 (COM_1), S85.2 (COM_2), SW3.S2; also elsewhere on the board
COL5: S9.1 (COM_1), S9.2 (COM_2), S18.1 (COM_1), S18.2 (COM_2), S71.1 (COM_1), S71.2 (COM_2), S76.1 (COM_1), S76.2 (COM_2), S79.1 (COM_1), S79.2 (COM_2), S86.1 (COM_1), S86.2 (COM_2); also elsewhere on the board
COL6: S10.1 (COM_1), S10.2 (COM_2), S19.1 (COM_1), S19.2 (COM_2), S72.1 (COM_1), S72.2 (COM_2), S77.1 (COM_1), S77.2 (COM_2), S80.1 (COM_1), S80.2 (COM_2), S87.1; also elsewhere on the board
COL7: S11.1 (COM_1), S11.2 (COM_2), S20.1 (COM_1), S20.2 (COM_2), S73.1 (COM_1), S73.2 (COM_2), S78.1 (COM_1), S78.2 (COM_2), S88.1, S94.1, SW4.S2; also elsewhere on the board
COL8: S12.1 (COM_1), S12.2 (COM_2), S21.1 (COM_1), S21.2 (COM_2), S74.1 (COM_1), S74.2 (COM_2), S89.1, SW5.S2; also elsewhere on the board
COL9: S90.1, S91.1, S92.1, S95.1; also elsewhere on the board
COL10: S93.1; also elsewhere on the board
CS1: S4.L3 (COM_A), S79.L3 (COM_A), S81.L3 (COM_A), U1.25 (CS9)
CS1_D2: S13.L3 (COM_A), S66.L3 (COM_A), S75.L3 (COM_A), U2.23 (CS7)
CS2: S5.L3 (COM_A), S80.L3 (COM_A), S82.L3 (COM_A), U1.26 (CS10)
CS2_D2: S14.L3 (COM_A), S67.L3 (COM_A), S76.L3 (COM_A), U2.22 (CS6)
CS3: S6.L3 (COM_A), S83.L3 (COM_A), U1.27 (CS11)
CS3_D2: S15.L3 (COM_A), S68.L3 (COM_A), S77.L3 (COM_A), U2.17 (CS2)
CS4: S7.L3 (COM_A), S84.L3 (COM_A), U1.19 (CS4)
CS4_D2: S16.L3 (COM_A), S69.L3 (COM_A), S78.L3 (COM_A), U2.25 (CS9)
CS5: S8.L3 (COM_A), S85.L3 (COM_A), U1.21 (CS5)
CS5_D2: S17.L3 (COM_A), S70.L3 (COM_A), U2.16 (CS1)
CS6: S9.L3 (COM_A), S86.L3 (COM_A), U1.22 (CS6)
CS6_D2: S18.L3 (COM_A), S71.L3 (COM_A), U2.19 (CS4)
CS7: S10.L3 (COM_A), U1.23 (CS7)
CS7_D2: S19.L3 (COM_A), S72.L3 (COM_A), U2.21 (CS5)
CS8: S11.L3 (COM_A), U1.24 (CS8)
CS8_D2: S20.L3 (COM_A), S73.L3 (COM_A), U2.24 (CS8)
CS9: S12.L3 (COM_A)
CS9_D2: S21.L3 (COM_A), S74.L3 (COM_A), U2.18 (CS3)
GND: C1.2, C2.2, C3.2, C4.2, C5.2, C6.2, C17.2, C18.2, C19.2, C20.2, C21.2, C22.2, C23.2, C24.2, C25.2, C26.2, R10.1, R11.1, R14.1, R15.1, SW1.C, SW2.C, SW3.C, SW4.C, SW5.C, U1.5 (PGND), U1.12 (PGND), U1.34 (AGND), U1.43 (ADDR1), U1.44 (ADDR2), U1.48 (GND), U1.49 (GND), U2.5 (PGND), U2.12 (PGND), U2.34 (AGND), U2.43 (ADDR1), U2.44 (ADDR2), U2.48 (GND), U2.49 (GND); also elsewhere on the board
Green1: S81.L4 (K_G), S82.L4 (K_G), S83.L4 (K_G), S84.L4 (K_G), S85.L4 (K_G), S86.L4 (K_G), U1.4 (SW3)
Green2: S79.L4 (K_G), S80.L4 (K_G), U1.7 (SW5)
Green3: S4.L4 (K_G), S5.L4 (K_G), S6.L4 (K_G), S7.L4 (K_G), S8.L4 (K_G), S9.L4 (K_G), S10.L4 (K_G), S11.L4 (K_G), S12.L4 (K_G), U1.10 (SW8)
Green4: S13.L4 (K_G), S14.L4 (K_G), S15.L4 (K_G), S16.L4 (K_G), S17.L4 (K_G), S18.L4 (K_G), S19.L4 (K_G), S20.L4 (K_G), S21.L4 (K_G), U2.9 (SW7)
Green5: S66.L4 (K_G), S67.L4 (K_G), S68.L4 (K_G), S69.L4 (K_G), S70.L4 (K_G), S71.L4 (K_G), S72.L4 (K_G), S73.L4 (K_G), S74.L4 (K_G), U2.6 (SW4)
Green6: S75.L4 (K_G), S76.L4 (K_G), S77.L4 (K_G), S78.L4 (K_G), U2.2 (SW1)
INTB: R16.2, R17.2, U1.45 (~INTB), U2.45 (~INTB); also elsewhere on the board
LEDS_SHUTDOWN: R1.2, R2.2, U1.46 (~SDB), U2.46 (~SDB); also elsewhere on the board
unnamed: D11.2 (A), S4.3 (NO_1), S4.4 (NO_2)
unnamed: D12.2 (A), S5.3 (NO_1), S5.4 (NO_2)
unnamed: D13.2 (A), S6.3 (NO_1), S6.4 (NO_2)
unnamed: D14.2 (A), S7.3 (NO_1), S7.4 (NO_2)
unnamed: D15.2 (A), S8.3 (NO_1), S8.4 (NO_2)
unnamed: D16.2 (A), S9.3 (NO_1), S9.4 (NO_2)
unnamed: D17.2 (A), S10.3 (NO_1), S10.4 (NO_2)
unnamed: D18.2 (A), S11.3 (NO_1), S11.4 (NO_2)
unnamed: D19.2 (A), S12.3 (NO_1), S12.4 (NO_2)
unnamed: D20.2 (A), S13.3 (NO_1), S13.4 (NO_2)
unnamed: D21.2 (A), S14.3 (NO_1), S14.4 (NO_2)
unnamed: D68.2 (A), S15.3 (NO_1), S15.4 (NO_2)
unnamed: D69.2 (A), S16.3 (NO_1), S16.4 (NO_2)
unnamed: D70.2 (A), S18.3 (NO_1), S18.4 (NO_2)
unnamed: D71.2 (A), S17.3 (NO_1), S17.4 (NO_2)
unnamed: D72.2 (A), S19.3 (NO_1), S19.4 (NO_2)
unnamed: D73.2 (A), S20.3 (NO_1), S20.4 (NO_2)
unnamed: D74.2 (A), S21.3 (NO_1), S21.4 (NO_2)
unnamed: D75.2 (A), S66.3 (NO_1), S66.4 (NO_2)
unnamed: D76.2 (A), S67.3 (NO_1), S67.4 (NO_2)
unnamed: D77.2 (A), S68.3 (NO_1), S68.4 (NO_2)
unnamed: D78.2 (A), S69.3 (NO_1), S69.4 (NO_2)
unnamed: D79.2 (A), S75.3 (NO_1), S75.4 (NO_2)
unnamed: D80.2 (A), S76.3 (NO_1), S76.4 (NO_2)
unnamed: D81.2 (A), S77.3 (NO_1), S77.4 (NO_2)
unnamed: D82.2 (A), S78.3 (NO_1), S78.4 (NO_2)
unnamed: D83.2 (A), S70.3 (NO_1), S70.4 (NO_2)
unnamed: D84.2 (A), S71.3 (NO_1), S71.4 (NO_2)
unnamed: D85.2 (A), S72.3 (NO_1), S72.4 (NO_2)
unnamed: D86.2 (A), S73.3 (NO_1), S73.4 (NO_2)
unnamed: D87.2 (A), S74.3 (NO_1), S74.4 (NO_2)
unnamed: D88.2 (A), S79.3 (NO_1), S79.4 (NO_2)
unnamed: D89.2 (A), S80.3 (NO_1), S80.4 (NO_2)
unnamed: D90.2 (A), S81.3 (NO_1), S81.4 (NO_2)
unnamed: D91.2 (A), S82.3 (NO_1), S82.4 (NO_2)
unnamed: D92.2 (A), S83.3 (NO_1), S83.4 (NO_2)
unnamed: D93.2 (A), S84.3 (NO_1), S84.4 (NO_2)
unnamed: D94.2 (A), S85.3 (NO_1), S85.4 (NO_2)
unnamed: D95.2 (A), S86.3 (NO_1), S86.4 (NO_2)
unnamed: D96.2 (A), S87.2
unnamed: D97.2 (A), S88.2
unnamed: D98.2 (A), S89.2
unnamed: D99.2 (A), S90.2
unnamed: D100.2 (A), S91.2
unnamed: D101.2 (A), S92.2
unnamed: D102.2 (A), S93.2
unnamed: D103.2 (A), S94.2
unnamed: D104.2 (A), S95.2
unnamed: RD6.2 (A), SW1.S1
unnamed: RD7.2 (A), SW2.S1
unnamed: RD8.2 (A), SW3.S1
unnamed: RD9.2 (A), SW4.S1
unnamed: RD10.2 (A), SW5.S1
unnamed: R10.2, U1.47 (IICRST)
unnamed: R11.2, U1.35 (RSET)
unnamed: R14.2, U2.47 (IICRST)
unnamed: R15.2, U2.35 (RSET)
ROW0: D103.1 (K), D104.1 (K); also elsewhere on the board
ROW1: D90.1 (K), D91.1 (K), D92.1 (K), D93.1 (K), D94.1 (K), D95.1 (K), D96.1 (K), D97.1 (K), D98.1 (K), D99.1 (K), D102.1 (K); also elsewhere on the board
ROW2: D88.1 (K), D89.1 (K), RD6.1 (K), RD7.1 (K), RD8.1 (K), RD9.1 (K), RD10.1 (K); also elsewhere on the board
ROW3: D11.1 (K), D12.1 (K), D13.1 (K), D14.1 (K), D15.1 (K), D16.1 (K), D17.1 (K), D18.1 (K), D19.1 (K), D101.1 (K); also elsewhere on the board
ROW4: D20.1 (K), D21.1 (K), D68.1 (K), D69.1 (K), D70.1 (K), D71.1 (K), D72.1 (K), D73.1 (K), D74.1 (K); also elsewhere on the board
ROW5: D75.1 (K), D76.1 (K), D77.1 (K), D78.1 (K), D83.1 (K), D84.1 (K), D85.1 (K), D86.1 (K), D87.1 (K); also elsewhere on the board
ROW6: D79.1 (K), D80.1 (K), D81.1 (K), D82.1 (K), D100.1 (K); also elsewhere on the board
Red1: S81.L2 (K_R), S82.L2 (K_R), S83.L2 (K_R), S84.L2 (K_R), S85.L2 (K_R), S86.L2 (K_R), U1.3 (SW2)
Red2: S79.L2 (K_R), S80.L2 (K_R), U1.8 (SW6)
Red3: S4.L2 (K_R), S5.L2 (K_R), S6.L2 (K_R), S7.L2 (K_R), S8.L2 (K_R), S9.L2 (K_R), S10.L2 (K_R), S11.L2 (K_R), S12.L2 (K_R), U1.11 (SW9)
Red4: S13.L2 (K_R), S14.L2 (K_R), S15.L2 (K_R), S16.L2 (K_R), S17.L2 (K_R), S18.L2 (K_R), S19.L2 (K_R), S20.L2 (K_R), S21.L2 (K_R), U2.10 (SW8)
Red5: S66.L2 (K_R), S67.L2 (K_R), S68.L2 (K_R), S69.L2 (K_R), S70.L2 (K_R), S71.L2 (K_R), S72.L2 (K_R), S73.L2 (K_R), S74.L2 (K_R), U2.7 (SW5)
Red6: S75.L2 (K_R), S76.L2 (K_R), S77.L2 (K_R), S78.L2 (K_R), U2.3 (SW2)
SCL: R8.2, R12.2, U1.42 (SCL), U2.42 (SCL); also elsewhere on the board
SDA: R9.2, R13.2, U1.41 (SDA), U2.41 (SDA); also elsewhere on the board
SW1A: SW1.A; also elsewhere on the board
SW1B: SW1.B; also elsewhere on the board
SW2A: SW2.A; also elsewhere on the board
SW2B: SW2.B; also elsewhere on the board
SW3A: SW3.A; also elsewhere on the board
SW3B: SW3.B; also elsewhere on the board
SW4A: SW4.A; also elsewhere on the board
SW4B: SW4.B; also elsewhere on the board
SW5A: SW5.A; also elsewhere on the board
SW5B: SW5.B; also elsewhere on the board

Notes on the sheet:
-Button
Rotary Encoders
Shift, Alt & Ctr
Driver1
Driver2
Up,Down,Left & Right buttons
+Button
Octagon2 Push buttons
Driver1 LEDs
Octagon1 Push buttons
Driver2 LEDs
Octagon3 Push buttons
Push buttons Matrix

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
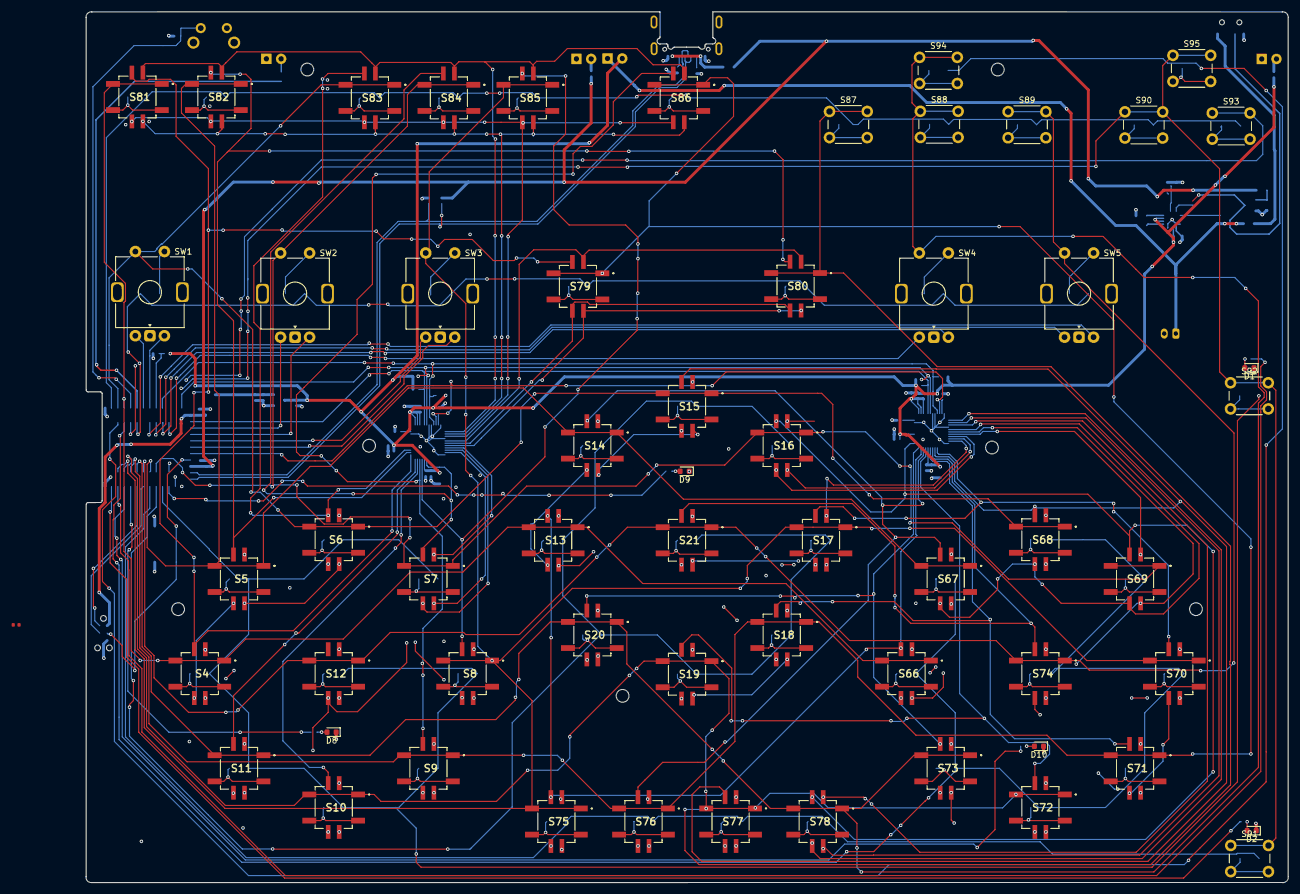
[picture p11: board Chord Board Controller.kicad_pcb from above]

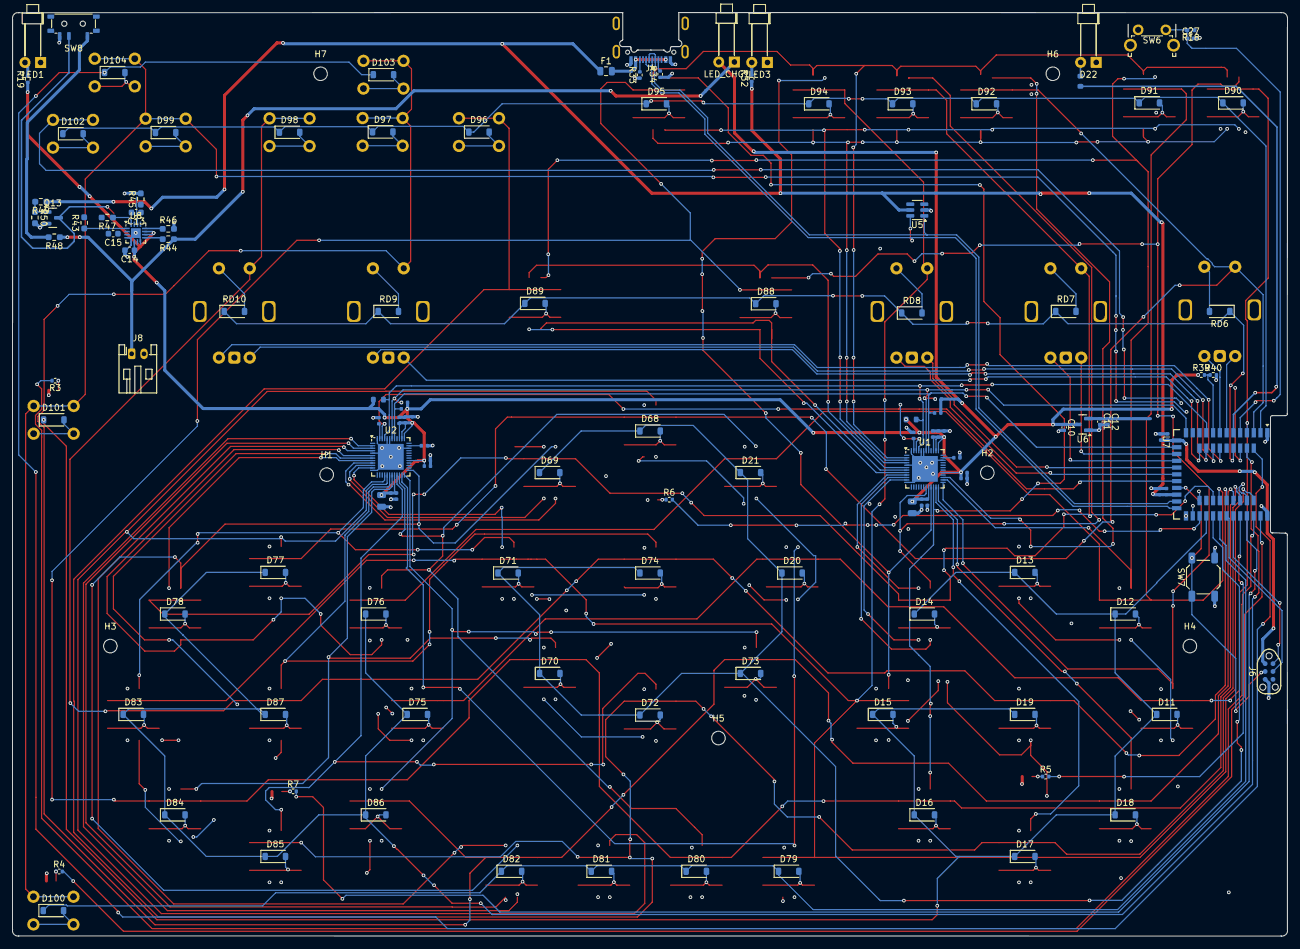
[picture p12: board Chord Board Controller.kicad_pcb from below]

Board: 4 copper layers, 207.0 x 149.9 mm, 197 parts (138 on the bottom side), 161 nets.

Other parts of the board:
F1: 500mA; Fuse_0805_2012Metric
