AronTech1/chord_hardware/(commit log)

2025-10-28 first review
    [BQ24075.STEP, Chord Board Controller.kicad_pcb, Chord Board Controller.kicad_sch, Chord Board Controller.step, IS31FL3733-QFLS4-TR.stp, PUSH BUTTONS.kicad_sch, untitled.kicad_sch, xyz.kicad_sch]
2025-10-28 cc Text
    [Chord Board Controller.kicad_sch]
